Taller-de-diseno-digital-GR01/Proyecto-2-Ahorcado/docs/diseño/diagramas/flowchart TD.png

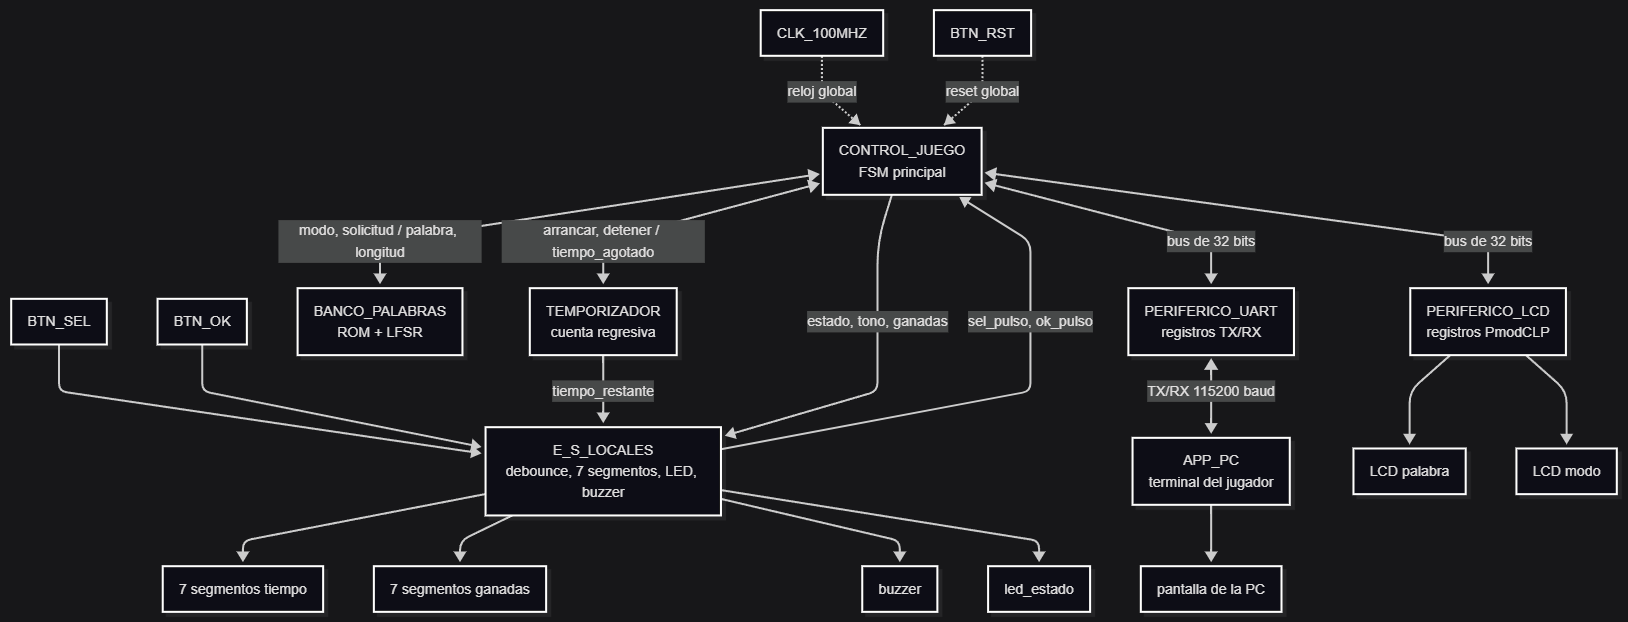
docs/diseño/diagramas/flowchart TD.png
