Taller-de-diseno-digital-GR01/Proyecto-2-Ahorcado/docs/informe/img/schematic_proyecto2.jpg

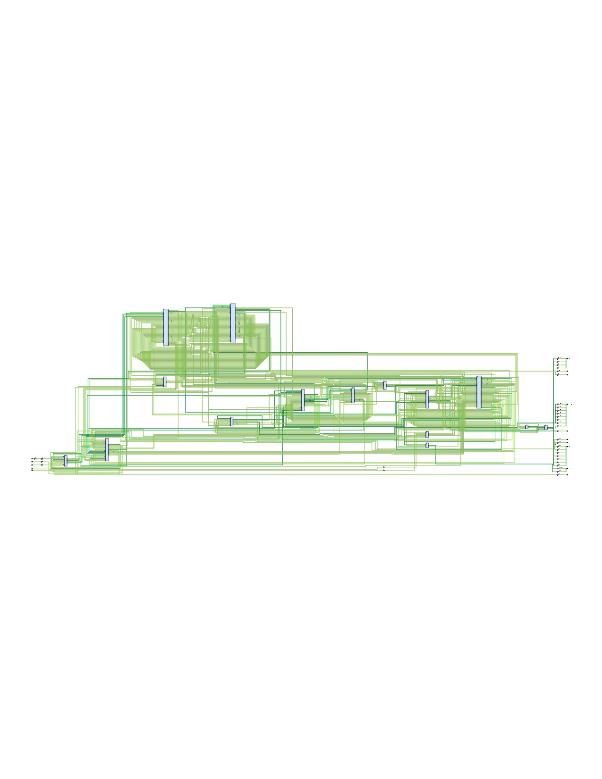
docs/informe/img/schematic_proyecto2.jpg
