Taller-de-diseno-digital-GR01/Proyecto-2-Ahorcado/docs/informe/schematic_proyecto2.pdf

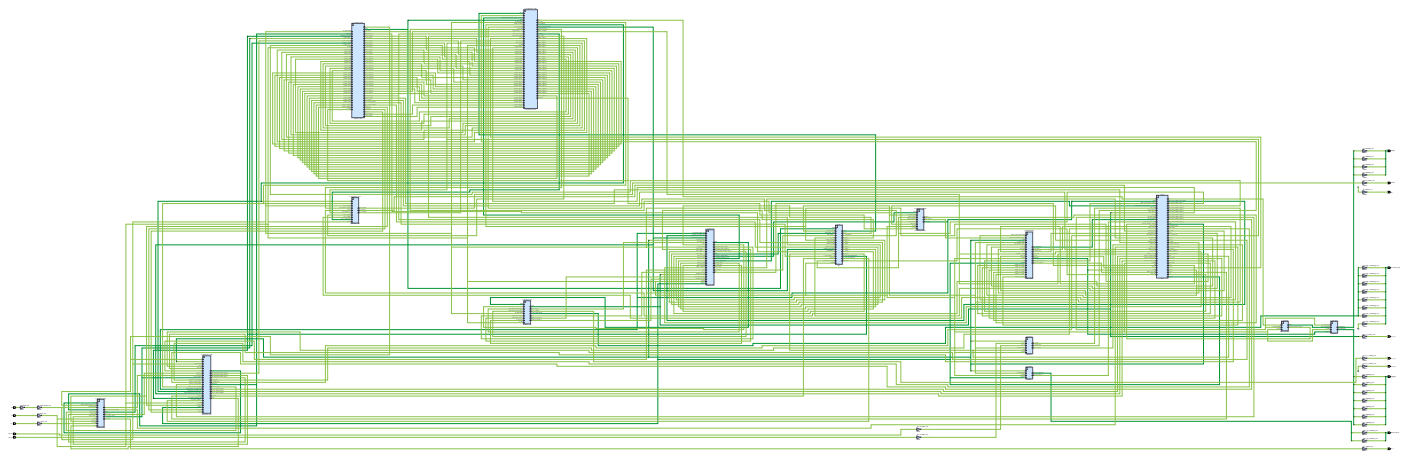
[picture p3: page 1]
clk; rst; rx_i btn_sel btn_ok; clk_IBUF_inst; IBUF I; clk_IBUF_BUFG_inst BUFG I; rst_IBUF_inst; rx_i_IBUF_inst; u_periferico_uart; periferico_uart; FSM_onehot_estado_reg[1] clk_IBUF_BUFG; new_rx__0; new_rx_reg_0; o_letra_reg[1] rst_IBUF; rx_bus_we; rx_i_IBUF; send0; tx_o_OBUF; FSM_sequential_estado_reg[1]; Q[3:0] estado[1:0]; reg_tx_reg[7]_0; reg_rx_reg[1]_0[1:0]; u_transmisor_uart; transmisor_uart; FSM_sequential_estado_reg[1]_1; clk_IBUF_BUFG; dec_fin; dec_fin_prev; dec_juego; dec_juego_prev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
