Taller-de-diseno-digital-GR01/Proyecto-2-Ahorcado/src/sim/tb_temporizador.sv

`timescale 1ns/1ps

// Testbench de temporizador. Corre con: make sim TB=temporizador (o make wave TB=temporizador)
//
// PRESCALER_RECARGA se sobreescribe a un valor chico (ver PRESC_TEST) para que un "segundo"
// del DUT dure unos pocos ciclos de clk en vez de 100_000_000 -- así se puede simular una
// cuenta regresiva completa (60 s, 45 s) sin esperar minutos de tiempo simulado real.
//
// Nota sobre el estilo: las comprobaciones y la espera de un tick se escriben como macros de
// preprocesador (`define), no como task/function. Se probo con task/function normales primero,
// pero en Icarus Verilog (probado en la version estable 12.0 y en la ultima de desarrollo) CUALQUIER
// llamada a una tarea o funcion dentro del bloque initial corrompe el siguiente @(posedge clk) del
// mismo proceso (el proceso "pierde" un flanco) -- reproducido de forma aislada y minimal, incluso
// con una tarea vacia que solo hace $display. Las macros no tienen ese problema porque son
// sustitucion de texto en tiempo de compilacion, no una llamada real en tiempo de simulacion.
//
// Desde que temporizador.sv paso a decodificar i_state en vez de recibir un pulso "start" externo
// (ver src/design/fsm.sv, f: la FSM ya no manda senales puntuales a nadie), este testbench arranca
// la cuenta llevando i_state a JUEGO en vez de pulsar un puerto "start" aparte.
module tb_temporizador;

    localparam logic [26:0] PRESC_TEST = 27'd3; // tick_1hz cada 4 ciclos de clk (cuenta 3,2,1,0)

    // Codigos de estado de la FSM principal (docs/diseño/modulos/M13_FSM.md, h)
    localparam logic [2:0] ST_SELECCION = 3'b000;
    localparam logic [2:0] ST_JUEGO     = 3'b010;
    localparam logic [2:0] ST_GANO      = 3'b011;
    localparam logic [2:0] ST_PERDIO    = 3'b100;

    logic       clk;
    logic       rst;
    logic [2:0] i_state;
    logic       modo;
    logic [7:0] tiempo;
    logic       tiempo_agotado;
    logic       fin_espera;

    int errores = 0;

    temporizador #(
        .PRESCALER_RECARGA(PRESC_TEST)
    ) dut (
        .clk(clk),
        .rst(rst),
        .i_state(i_state),
        .modo(modo),
        .tiempo(tiempo),
        .tiempo_agotado(tiempo_agotado),
        .o_fin_espera(fin_espera)
    );

    initial clk = 1'b0;
    always #5 clk = ~clk;

    // Empaqueta un valor decimal 0-99 al formato BCD {decenas, unidades} de la salida `tiempo`
    `define BCD(valor) {4'((valor) / 10), 4'((valor) % 10)}

    `define CHECK(nombre, got, expected) \
        if ((got) !== (expected)) begin \
            $display("FALLO [%0t ns] %s: se esperaba tiempo=%02h, se obtuvo %02h", $time, nombre, (expected), (got)); \
            errores = errores + 1; \
        end else begin \
            $display("OK    [%0t ns] %s: tiempo=%02h", $time, nombre, (got)); \
        end

    `define CHECK_BIT(nombre, got, expected) \
        if ((got) !== (expected)) begin \
            $display("FALLO [%0t ns] %s: se esperaba %0b, se obtuvo %0b", $time, nombre, (expected), (got)); \
            errores = errores + 1; \
        end else begin \
            $display("OK    [%0t ns] %s: %0b", $time, nombre, (got)); \
        end

    // Avanza exactamente un periodo de tick_1hz (PRESC_TEST+1 ciclos de clk). El prescaler
    // corre libre, sin resincronizarse con la entrada a JUEGO, asi que el periodo entre pulsos
    // siempre es el mismo sin importar que paso antes -- basta con esperar un periodo completo
    // para garantizar que paso exactamente un tick_1hz.
    //
    // El "#1" final es para dejar asentar las actualizaciones NBA antes de leer cualquier señal
    // del DUT justo despues: en pruebas se vio que, en este build de Icarus Verilog, leer una
    // señal en el mismo instante de simulacion que el flanco que la actualiza a veces devuelve
    // el valor viejo (no es un problema del diseño, sino de cuando el testbench lee el valor).
    `define ESPERA_TICK repeat (PRESC_TEST + 1) @(posedge clk); #1;

    // Entra a JUEGO desde otro estado para generar un flanco 0->1 de dec_juego dentro del DUT,
    // que es lo que ahora dispara la carga del tiempo inicial (equivalente al viejo pulso "start")
    `define ARRANCA_JUEGO \
        i_state = ST_SELECCION; \
        @(posedge clk); #1; \
        i_state = ST_JUEGO; \
        @(posedge clk); #1;

    initial begin
        $dumpfile("tb_temporizador.vcd");
        $dumpvars(0, tb_temporizador);

        // 1) Reset: tiempo en 0, tiempo_agotado en 0, fin_espera en 0
        rst = 1'b1; i_state = ST_SELECCION; modo = 1'b0;
        repeat (2) @(posedge clk);
        rst = 1'b0;
        @(posedge clk); #1;
        `CHECK("reset: tiempo", tiempo, `BCD(0))
        `CHECK_BIT("reset: tiempo_agotado", tiempo_agotado, 1'b0)
        `CHECK_BIT("reset: fin_espera", fin_espera, 1'b0)

        // 2) Sin entrar a JUEGO, tiempo se queda en 0 y tiempo_agotado NO debe activarse solo:
        //    corrige el caso de "agotado falso" apenas sale del reset, antes de correr nunca.
        `ESPERA_TICK
        `ESPERA_TICK
        `CHECK("idle en SELECCION: tiempo", tiempo, `BCD(0))
        `CHECK_BIT("idle en SELECCION: tiempo_agotado", tiempo_agotado, 1'b0)
        `CHECK_BIT("idle en SELECCION: fin_espera", fin_espera, 1'b0)

        // 3) Entrar a JUEGO en modo facil (0) carga 60 s
        modo = 1'b0;
        `ARRANCA_JUEGO
        `CHECK("entrar a JUEGO facil: tiempo inicial", tiempo, `BCD(60))
        `CHECK_BIT("entrar a JUEGO facil: tiempo_agotado limpio", tiempo_agotado, 1'b0)

        // 4) Cuenta regresiva completa 60 -> 0, revisando el acarreo BCD en cada decena
        for (int i = 59; i >= 0; i = i - 1) begin
            `ESPERA_TICK
            `CHECK($sformatf("cuenta facil: %0d s restantes", i), tiempo, `BCD(i))
        end

        // 5) Al llegar a 0: tiempo_agotado se levanta, running se apaga solo y el tiempo
        //    ya no sigue bajando (no da la vuelta a 99).
        //    running/tiempo_agotado usan el "zero" del ciclo anterior, asi que reflejan el
        //    tiempo=0 recien escrito un ciclo de clk despues -- de ahi este @(posedge clk) extra.
        @(posedge clk); #1;
        `CHECK_BIT("fin de cuenta: tiempo_agotado", tiempo_agotado, 1'b1)
        `CHECK_BIT("fin de cuenta: running se apago solo", dut.running, 1'b0)
        `ESPERA_TICK
        `ESPERA_TICK
        `CHECK("fin de cuenta: tiempo se mantiene en 0", tiempo, `BCD(0))
        `CHECK_BIT("fin de cuenta: tiempo_agotado se mantiene", tiempo_agotado, 1'b1)

        // 6) La FSM pasa a GANO al terminar la partida. A los 3 tick_1hz de estar ahi,
        //    fin_espera se levanta para que la FSM pueda volver a SELECCION.
        i_state = ST_GANO;
        @(posedge clk); #1;
        `CHECK_BIT("entrar a GANO: fin_espera arranca en 0", fin_espera, 1'b0)
        // tiempo_agotado venia en 1 de la seccion 5. Se limpia al entrar al estado de fin, asi
        // la FSM no lo ve en el primer ciclo de JUEGO de la partida siguiente.
        @(posedge clk); #1;
        `CHECK_BIT("GANO: tiempo_agotado se limpia al entrar al estado de fin", tiempo_agotado, 1'b0)
        `ESPERA_TICK
        `CHECK_BIT("GANO: 1er tick_1hz, fin_espera aun en 0", fin_espera, 1'b0)
        `ESPERA_TICK
        `CHECK_BIT("GANO: 2do tick_1hz, fin_espera aun en 0", fin_espera, 1'b0)
        `ESPERA_TICK
        `CHECK_BIT("GANO: 3er tick_1hz, fin_espera en 1", fin_espera, 1'b1)

        // 7) Salir de GANO no limpia fin_espera todavia, se queda en 1 en SELECCION/CARGA (la FSM
        //    lo ignora ahi) y se limpia con el start de la siguiente partida, antes de que la FSM
        //    pueda volver a un estado de fin.
        i_state = ST_SELECCION;
        @(posedge clk); #1;
        `CHECK_BIT("salir de GANO: fin_espera sigue en 1", fin_espera, 1'b1)

        // 7.5) Ganar o perder por intentos, con tiempo de sobra: entrar a GANO antes de que el
        //      tiempo llegue a 0 tiene que apagar running y resetear tiempo a 00 de inmediato,
        //      en vez de seguir contando en el fondo mientras se muestra el resultado.
        modo = 1'b0;
        `ARRANCA_JUEGO
        `CHECK_BIT("nueva partida: start limpia el fin_espera de la anterior", fin_espera, 1'b0)
        `ESPERA_TICK
        `ESPERA_TICK
        `CHECK("con tiempo de sobra: tiempo antes de ganar", tiempo, `BCD(58))
        i_state = ST_GANO;
        @(posedge clk); #1;
        `CHECK_BIT("ganar con tiempo de sobra: running se apaga", dut.running, 1'b0)
        `CHECK("ganar con tiempo de sobra: tiempo se resetea a 00", tiempo, `BCD(0))
        `ESPERA_TICK
        `ESPERA_TICK
        `CHECK("ganar con tiempo de sobra: tiempo se queda en 00", tiempo, `BCD(0))
        `CHECK_BIT("ganar con tiempo de sobra: tiempo_agotado no se activa", tiempo_agotado, 1'b0)

        // 8) Un nuevo start en modo dificil (1), entrando de nuevo a JUEGO, recarga con 45 s
        modo = 1'b1;
        `ARRANCA_JUEGO
        `CHECK("entrar a JUEGO dificil: tiempo inicial", tiempo, `BCD(45))
        `CHECK_BIT("entrar a JUEGO dificil: tiempo_agotado se limpia", tiempo_agotado, 1'b0)

        // 9) Cuenta regresiva completa en modo dificil, cruzando otra decena (45 -> 40 -> ... -> 0)
        for (int i = 44; i >= 0; i = i - 1) begin
            `ESPERA_TICK
            `CHECK($sformatf("cuenta dificil: %0d s restantes", i), tiempo, `BCD(i))
        end
        @(posedge clk); #1; // ver nota de sincronizacion en la seccion 5
        `CHECK_BIT("fin de cuenta dificil: tiempo_agotado", tiempo_agotado, 1'b1)

        // 10) Esta vez la partida se pierde: PERDIO tambien cuenta sus 3 s de fin_espera. El
        //     fin_espera de la ronda de GANO anterior ya lo limpio el start, asi que la FSM lo ve
        //     en 0 desde el primer ciclo de PERDIO, antes del flanco de entrada.
        `CHECK_BIT("antes de entrar a PERDIO: fin_espera ya estaba en 0", fin_espera, 1'b0)
        i_state = ST_PERDIO;
        @(posedge clk); #1;
        `CHECK_BIT("entrar a PERDIO: fin_espera sigue en 0", fin_espera, 1'b0)
        `ESPERA_TICK
        `ESPERA_TICK
        `ESPERA_TICK
        `CHECK_BIT("PERDIO: a los 3 tick_1hz, fin_espera en 1", fin_espera, 1'b1)

        // 11) rst limpia todo de nuevo, incluso con tiempo_agotado y fin_espera en alto.
        //    Se mantiene 2 ciclos (igual que el reset inicial) para evitar una carrera entre
        //    el "rst=0" del testbench y el flanco en el que el DUT todavia debe ver rst=1.
        rst = 1'b1;
        repeat (2) @(posedge clk);
        rst = 1'b0;
        @(posedge clk); #1;
        `CHECK("rst final: tiempo", tiempo, `BCD(0))
        `CHECK_BIT("rst final: tiempo_agotado", tiempo_agotado, 1'b0)
        `CHECK_BIT("rst final: fin_espera", fin_espera, 1'b0)

        if (errores == 0)
            $display("\n=== TODAS LAS PRUEBAS PASARON ===");
        else
            $display("\n=== %0d PRUEBA(S) FALLARON ===", errores);

        $finish;
    end

endmodule
