Taller-de-diseno-digital-GR01/Proyecto-2-Ahorcado/(commit log)

2026-08-30 agregar gitignore para build y artefactos de sintesis
2026-08-30 agregar readme con la estructura del repo
2026-08-30 esqueleto de docs para diseno e informe
2026-08-30 esqueleto de src, top vacio y placeholders de sim y fpga
2026-08-30 agregar carpeta sw para la app de pc
2026-09-03 esqueleto de diagrama de nivel 02
2026-09-03 Formato corregido para título
2026-09-03 nivel02.md: CJ se veía blanco puro en dark mode de github por el fill fijo, y acorto el cierre
2026-09-03 Diagrama nivel 3 - Creación de más módulos
2026-09-03 flowchart_nivel3: nombres de modulo en español, calzando con el resto de la doc
2026-09-03 flowchart_nivel3: BTN_RST explicito en vez de un rst generico, calzando con nivel 1 y 2
2026-09-03 flowchart_nivel3: agregar tiempo_agotado y detener entre la FSM y el temporizador
2026-09-03 flowchart_nivel3: renombrar REG_WI a REG_Letra-in, se confundia con la palabra secreta
2026-09-03 flowchart_nivel3: agrupar los modulos en subgraphs que calzan con los bloques de nivel 2
2026-09-03 flowchart_nivel3: mover UART y LCD adentro de FPGA, renombrar a PERIFERICO_UART/PERIFERICO_LCD
2026-09-03 flowchart_nivel3: mapa de bits real de los registros de LCD y UART, conectados por el bus de 32 bits
2026-09-04 Devulto un commit - M{odulos dentro de FPGA
2026-09-04 Archivos de módulos definidos con pequeña descripción
2026-09-04 Primer commit para M13_FSM
2026-09-04 M13_FSM: tabla de transiciones y justificacion de la codificacion
2026-09-04 diseno de M05_Estado listo
2026-09-04 diseno de M06_Ganadas listo
2026-09-04 Corrección de módulos
2026-09-04 Cambio de nombre del archivo M09
2026-09-04 M07: tablas de verdad de la evaluacion de letra
2026-09-04 agregar el descarte de bytes fuera de partida a M10
2026-09-04 M10: tabla del acceso al bus y del filtrado de letras
2026-09-04 Diagramas de M10 listos
2026-09-04 saturacion del contador de intentos documentada
2026-09-04 M13_FSM: tabla del registro de modo
2026-09-04 nivel03: agregar las señales que le faltaban a M07
2026-09-04 4to nivel Módulos 2-8-11. Módulo UART dado por el profe
2026-09-06 Primer commit para contador_intentos
2026-09-06 cuenta de fallos con limpieza al entrar a CARGA
2026-09-06 bandera de intentos agotados
2026-09-06 contador_intentos.sv: la cuenta daba la vuelta y apagaba la bandera de agotados
2026-09-06 Primer commit para comparador_letra
2026-09-06 comparacion paralela contra las posiciones validas de la palabra
2026-09-06 mascara de reveladas y registro de letras usadas
2026-09-06 evaluacion de la letra, acierto fallo o repetida
2026-09-06 Primer commit para receptor_uart
2026-09-06 fsm de sondeo del periferico uart
2026-09-06 acceso al bus, direccion y limpieza de new_rx
2026-09-06 quitar el comentario de cabecera
2026-09-06 sin la cabecera que apunta al doc
2026-09-06 quitar la referencia al doc en la cabecera
2026-09-07 debounce + detector de flanco
2026-09-07 primera instancia de M01_Marcador y su tb
2026-09-07 Primera instancia de M05_Estado y su tb
2026-09-07 Primera instancia de M06_Estado y su tb
2026-09-07 Primer commit para tb_receptor_uart
2026-09-07 Primer commit para tb_comparador_letra
2026-09-07 chequeos del reset y de lo que deja CARGA
    [tb_comparador_letra.sv]
2026-09-07 comentar por que la comparacion es mayor o igual
2026-09-07 Primer commit para tb_contador_intentos
2026-09-07 modelo del periferico y el recorrido de un byte bueno
2026-09-07 chequeo con conteo de errores y reporte a consola
    [tb_contador_intentos.sv]
2026-09-07 bordes del rango A-Z y bytes que se botan
2026-09-07 acierto, fallo y repetida, con el largo de los pulsos
2026-09-07 casos de la cuenta y de la saturacion
2026-09-07 palabra completa, relleno y palabra de largo maximo
2026-09-07 Testbench de receptor_uart listo
2026-09-07 Testbench de contador_intentos listo
2026-09-07 Testbench de comparador_letra listo
2026-09-07 comparador_letra.sv: la evaluacion le contestaba a una letra que llegaba en CARGA
2026-09-07 cubrir la letra que llega en CARGA
2026-09-07 comentario mas simple en la reduccion
2026-09-07 transcribir el UART_rx del profe para poder simularlo
2026-09-07 registrador de la atencion del receptor
2026-09-07 Testbench de receptor_uart rehecho sobre el nucleo del profe
2026-09-07 cambiado el nombre de archivos para respetar formato y borrados comentarios innecesarios
2026-09-07 cambiados nombres de archivos para respetar formato y borrados comentarios innecesarios
2026-09-07 Cambiado el nombre de archivos para respetar formato
2026-09-08 receptor_uart.sv: las direcciones no eran las que fija el enunciado
2026-09-08 alinear el modelo del periferico con el mapa nuevo
2026-09-08 renombrar i_try a i_intentos, try es el pulso de M07
2026-09-08 el patron actualizado va en la trama de letra, lo pide 3.4.4
2026-09-08 Primer commit para tb_transmisor_uart
2026-09-08 tramas de inicio, letra y fin
2026-09-08 Testbench de transmisor_uart listo
2026-09-08 uart_rx portado del vhd del profe
2026-09-08 el testbench usa el nucleo de diseño y no su propia copia
2026-09-08 uart_tx portado del vhd del profe
2026-09-08 lazo cerrado del transmisor contra el receptor
2026-09-08 Testbench de uart_tx listo
2026-09-08 Primer commit para periferico_uart, los tres registros y los dos nucleos
2026-09-08 acceso a los registros por el bus de 32 bits
2026-09-08 Testbench de periferico_uart listo, con el byte dando la vuelta por la linea
2026-09-08 Primer commit para arbitro_uart, prioridad al receptor
2026-09-08 el transmisor se aguanta cuando el arbitro le corta el bus
2026-09-08 quien gana el bus y que lee el que lo pierde
2026-09-08 Testbench de arbitro_uart listo
2026-09-08 Documentación de Pmod añadida
2026-09-09 ficha de nivel 4 para periferico_uart
2026-09-09 ficha de nivel 4 para arbitro_uart
2026-09-09 M11_Transmisor-UART.md: seguia con la trama de letra de tres bytes y sin bus_libre
2026-09-09 M10_Receptor-UART.md: nombres de puerto viejos y el arbitraje todavia como pendiente
2026-09-09 diseño.md al dia con las cuatro fichas del uart
2026-09-09 enlazar las fichas del periferico y del arbitro desde el readme
2026-09-10 GNUmakefile: doas hardcodeado no sirve fuera de FreeBSD
2026-09-10 Primer commit para la app de pc
2026-09-10 decodificador de las tramas I, L y F
2026-09-10 la app imprime los eventos y no los bytes crudos
2026-09-10 el estado espejo de la partida
2026-09-10 reconstruir el patron con el delta de la mascara
2026-09-10 el filtro A-Z antes de mandar la letra
2026-09-10 lazo de eventos con select sobre stdin y el puerto
2026-09-10 pintado de la pantalla
2026-09-10 Pruebas de la app listas, 23 casos sin tarjeta
2026-09-10 ficha de la app de pc
2026-09-10 primera parte de la lógica
2026-09-10 Makefile para wind*ws añadido
2026-09-10 Links de documentación agregada para librerias usadas
2026-09-10 Parametrización de UART lista
2026-09-10 Cambios en interfaz de menú
2026-09-11 un identificador no sirve como tamaño de literal, los ceros del bus van con '0
2026-09-11 transmisor_uart.sv: usaba WIDTH sin tenerlo en la lista de parámetros
2026-09-11 el ancho del byte serial es 8 fijo y no una fracción de WIDTH
2026-09-12 target test-app para las pruebas de la app de pc
2026-09-12 mensaje en vez de trama en los comentarios de la app
2026-09-12 la ficha de la app habla de mensajes y ciclo principal
2026-09-12 APP_PC.md: faltaba el chequeo de teclado en la sección de pruebas
2026-09-12 Módulo M02 Buzzer probado
    [Estado.sv, basys3.xdc, marcador.sv, top_generador_tono.sv, top_marcador_intentos_ganadas.sv]
2026-09-12 Cambio en Marcador - Ya no hace conversión de tiempo_juego
2026-09-12 tiempo de rst 3s probado
2026-09-12 LCD funcional con bug en primera letra
    [basys3.xdc, top_mostrar_lcd.sv]
2026-09-13 Incio pruebas UART
2026-09-13 top.sv listo (sin banco de palabras)
2026-09-13 top.sv para probar en hardware
2026-09-14 Agregado un pequeño modulo de desempaquetamiento para la palabra seleccionada y la logica para el banco de palabras
2026-09-14 Prrueba de top harcodeado
2026-09-14 comparador_letra.sv: el try salia un ciclo tarde y la trama L llevaba los intentos de la letra anterior
2026-09-14 el testbench anota o_try a mitad del ciclo
2026-09-14 M07_Comparador-letra.md: faltaba explicar que try sale en el mismo ciclo que la letra
2026-09-14 correción de word_Maxlen
2026-09-14 top con banco de palabras
2026-09-14 BUG #27 resuelto, ver https://github.com/Taller-de-diseno-digital-GR01/Proyecto-2-Ahorcado/issues/27
    [tb_transmisor_uart.sv]
2026-09-14 M12_Contador-Intentos.md: decia que la resta de intentos la hacia M11
2026-09-14 ficha de M07 con los puertos reales
2026-09-14 Ficha de M10 actualizada contra el top
2026-09-14 j) de M11 con las conexiones reales del top
2026-09-14 a) a d) que le faltaban al arbitro
2026-09-14 APP_PC.md: faltaba el orden de los bits de la mascara
2026-09-14 arbitro dibujado en el nivel 3
2026-09-15 LCD - Muestra cuenta de intentos
2026-09-16 tb de mostrarLCD actualizado
2026-09-16 corrección de error
2026-09-16 GNUmakefile: make all corre tambien la app de pc despues de programar
2026-09-17 Actulización diseños M03,04,09,13 + corrección de bug
    [tb_temporizador.sv, temporizador.sv]
2026-09-17 APP_PC.md: no decia nada de make app ni de make all
2026-09-17 nivel 2 del periferico uart y de la app al dia
2026-09-17 puertos de las fichas del uart con coma y no con dos puntos
2026-09-17 diseño.md sincronizado otra vez con las fichas del uart y la app
2026-09-18 nivel03.md: la respuesta de la fpga a la pc no tenia arista
2026-09-18 Actualizados los archivos en la carpeta docs/diseño/diagramas para que correspondan a la lógica y arquitectura actuales
2026-09-18 Verificacion de M07 en la ficha
2026-09-18 Verificacion de M10 en la ficha
2026-09-18 Verificacion de M11 en la ficha
2026-09-18 Verificacion de M12 en la ficha
2026-09-18 Verificacion del periferico uart y de los dos nucleos
2026-09-18 Verificacion del arbitro en la ficha
2026-09-18 APP_PC.md: no decia que la app nunca se ha probado contra la tarjeta
2026-09-18 los .py ya no repiten arriba lo que dice APP_PC.md
2026-09-18 Actualizados los archivos .md para la mayoría de los módulos numerados para que correspondan al duseño actual
2026-09-18 Arreglados Diagrama de Nivel 3 y Modulo 7 de pequeños errores
2026-09-18 Cambio final a diseño.md para que todo sea concordante con la arquitectura actual
